FrostEvil/Industrial-Modbus-MQTT-Gateway-/node-red-dashboard/dashboard-overview.png

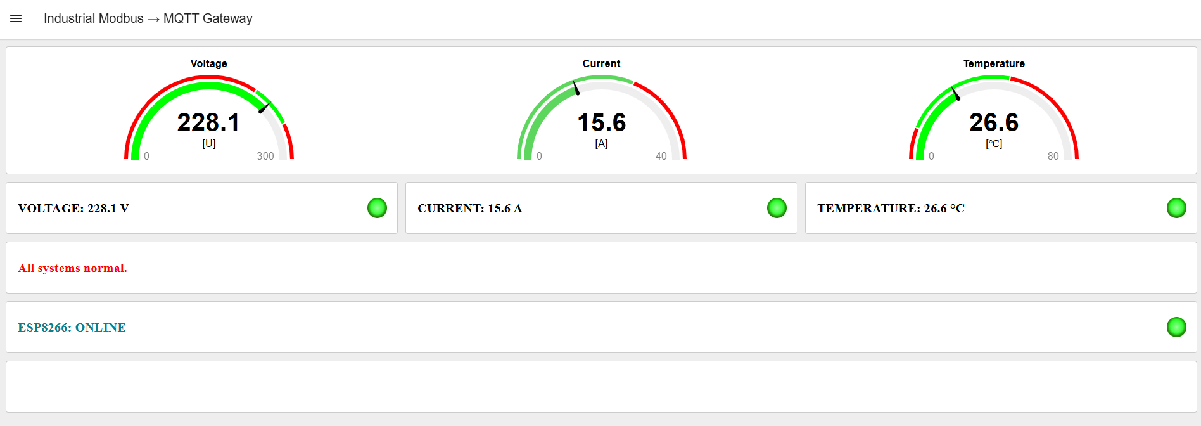
node-red-dashboard/dashboard-overview.png
