FrostEvil/Industrial-Modbus-MQTT-Gateway-/node-red-dashboard/flow-editor.png

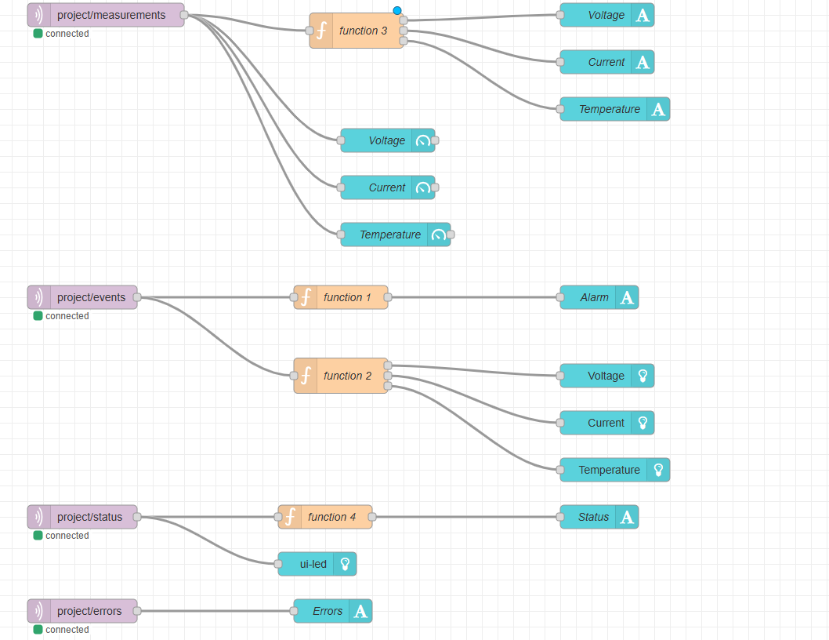
node-red-dashboard/flow-editor.png
