FrostEvil/Industrial-Modbus-MQTT-Gateway-/hardware/schematic.pdf

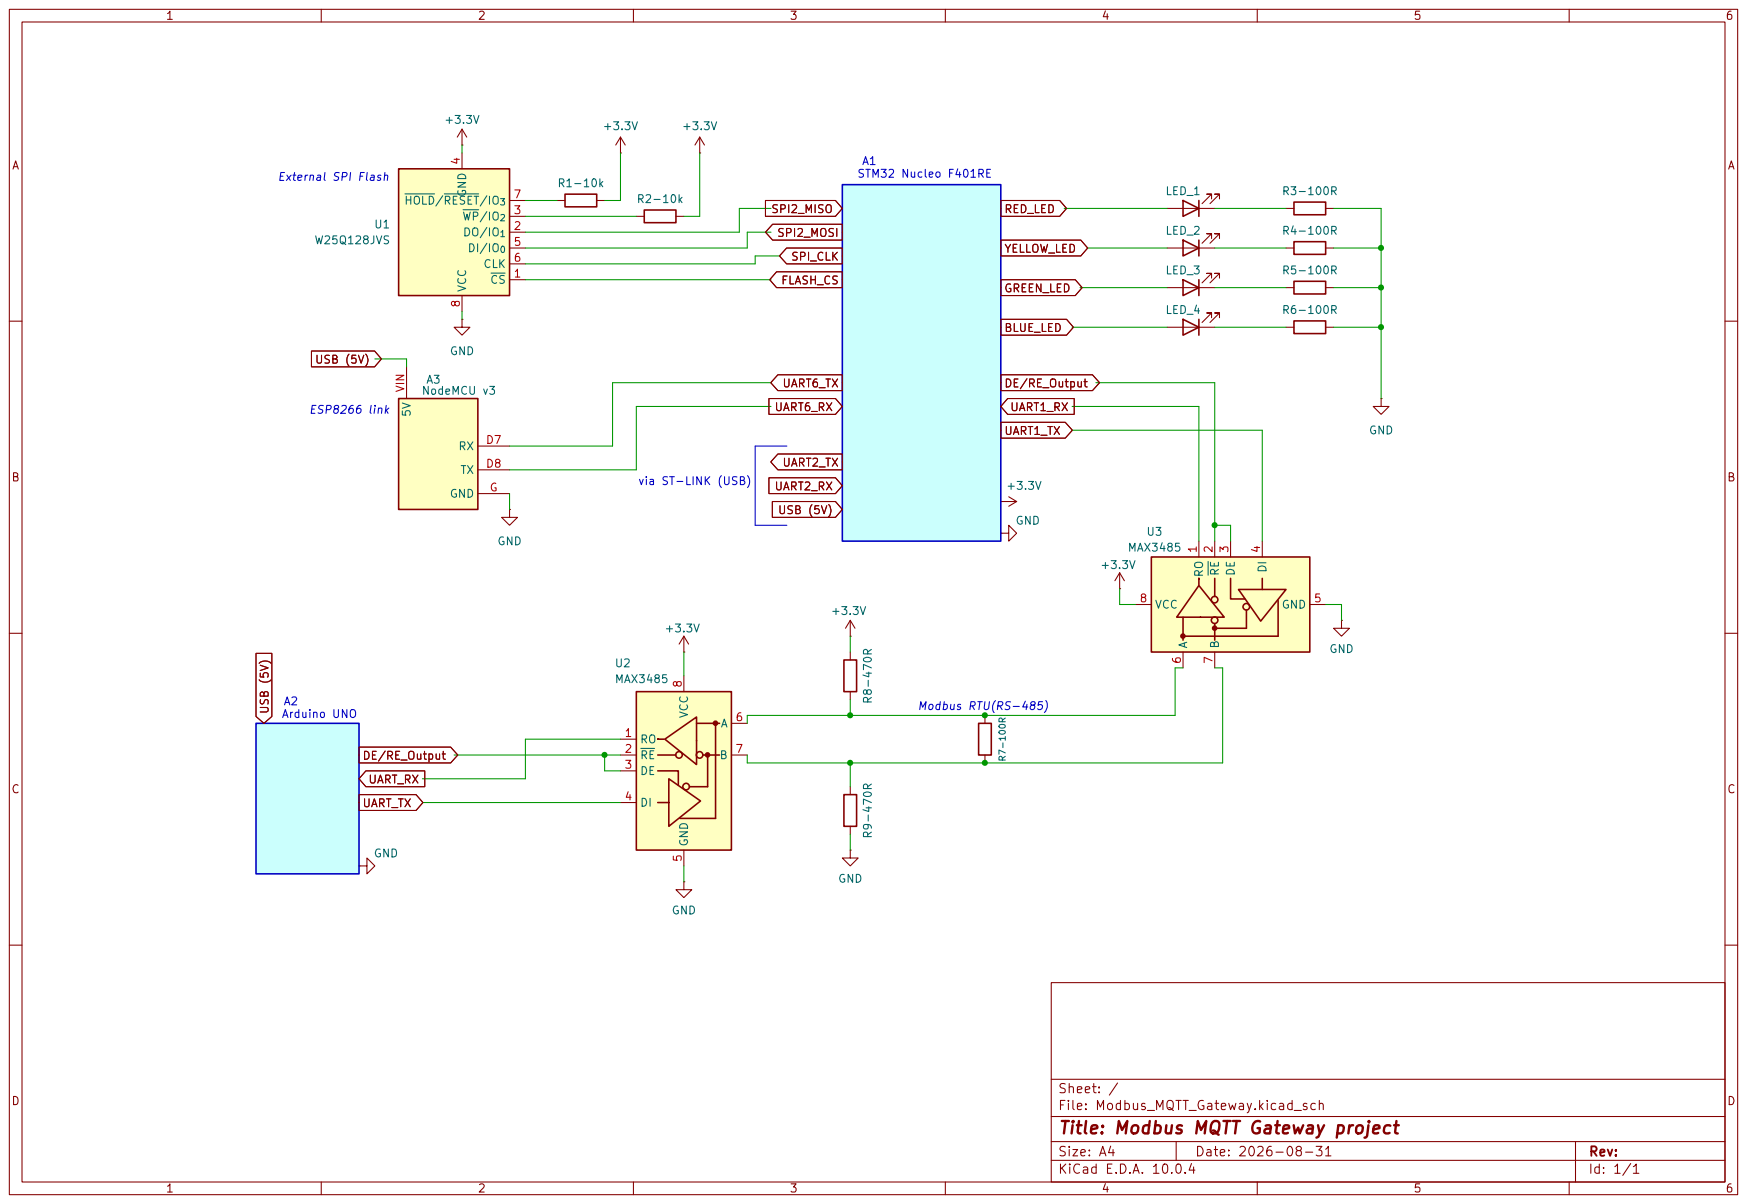
[picture p4: page 1]
