FrostEvil/Industrial-Modbus-MQTT-Gateway-/Core/Inc/main.h

#define B1_Pin GPIO_PIN_13
#define B1_GPIO_Port GPIOC
#define FLASH_CS_Pin GPIO_PIN_1
#define FLASH_CS_GPIO_Port GPIOC
#define USART_TX_Pin GPIO_PIN_2
#define USART_TX_GPIO_Port GPIOA
#define USART_RX_Pin GPIO_PIN_3
#define USART_RX_GPIO_Port GPIOA
#define LD2_Pin GPIO_PIN_5
#define LD2_GPIO_Port GPIOA
#define DE_RE_Output_Pin GPIO_PIN_12
#define DE_RE_Output_GPIO_Port GPIOB
#define ALARM_COMMUNICATION_Pin GPIO_PIN_13
#define ALARM_COMMUNICATION_GPIO_Port GPIOB
#define ALARM_MEASUREMENT_Pin GPIO_PIN_14
#define ALARM_MEASUREMENT_GPIO_Port GPIOB
#define ALARM_NORMAL_Pin GPIO_PIN_15
#define ALARM_NORMAL_GPIO_Port GPIOB
#define ALARM_STORAGE_FAULT_Pin GPIO_PIN_6
#define ALARM_STORAGE_FAULT_GPIO_Port GPIOC
#define TMS_Pin GPIO_PIN_13
#define TMS_GPIO_Port GPIOA
#define TCK_Pin GPIO_PIN_14
#define TCK_GPIO_Port GPIOA
#define SWO_Pin GPIO_PIN_3
#define SWO_GPIO_Port GPIOB
