FrostEvil/Industrial-Modbus-MQTT-Gateway-/Core/Src/alarm_manager_task.c

/*
 * alarm_manager_task.c
 *
 *  Created on: Jul 16, 2026
 *      Author: tomas
 */

#include "alarm_manager_task.h"
#include "app_queues.h"
#include "gpio.h"
#include "FreeRTOS.h"
#include "task.h"
#include "queue.h"
#include "flash_logger_task.h"
#include "flash_logger.h"
#include <string.h>
#include <stdbool.h>

#define VOLTAGE_MIN 207
#define VOLTAGE_MAX 253
#define VOLTAGE_HYSTERESIS 1

#define CURRENT_MIN 0
#define CURRENT_MAX 25
#define CURRENT_HYSTERESIS 0.5

#define TEMPERATURE_MIN 10
#define TEMPERATURE_MAX 45
#define TEMPERATURE_HYSTERESIS 1

#define MEASUREMENT_BIT_VOLTAGE   0x01
#define MEASUREMENT_BIT_CURRENT   0x02
#define MEASUREMENT_BIT_TEMP      0x04

TaskHandle_t alarmManagerTaskHandle;

#define ALARM_MANAGER_TASK_STACK_SIZE 128
static StackType_t alarmManagerTaskStack[ALARM_MANAGER_TASK_STACK_SIZE];
static StaticTask_t alarmManagerTaskTCB;

/*
 * True when value is outside [min, max]. No hysteresis here - that is
 * applied separately in update_measurement_status(), since the allowed
 * transition depends on the channel's previous state.
 */
static bool is_measurement_out_of_range(float value, float min, float max) {
	if (value <= max && value >= min) {
		return false;
	}

	return true;
}

/*
 * A channel already in alarm should not clear immediately when the value
 * crosses back over the original limit - it must first enter the narrower
 * hysteresis band.
 *
 * Example (voltage): normal range 207...253 V, hysteresis 1 V -> after an
 * alarm, the value must return to 208...252 V before it clears.
 */
static bool should_clear_alarm(float value, float min, float max,
		float hysteresis) {

	if ((value >= min + hysteresis) && (value <= max - hysteresis)) {
		return true;
	}

	return false;
}

/*
 * Update one channel using its previous state: normal limits decide
 * whether an alarm starts, hysteresis limits decide whether it clears.
 */
static MeasurementRangeStatus_t update_measurement_status(
		MeasurementRangeStatus_t current_status, float value, float min,
		float max, float hysteresis) {

	if (current_status == MEASUREMENT_IN_RANGE) {

		if (is_measurement_out_of_range(value, min, max)) {
			return MEASUREMENT_OUT_OF_RANGE;
		}

	} else {

		if (should_clear_alarm(value, min, max, hysteresis)) {
			return MEASUREMENT_IN_RANGE;
		}
	}

	return current_status;
}

/*
 * A communication error gets its own alarm state; the V/I/T channel states
 * are deliberately left untouched so a temporary Modbus failure does not
 * make the system "forget" an active measurement alarm.
 */
static void update_measurement_alarm_state(
		MeasurementRecord_t *measurement_message, AlarmState_t *alarm_state,
		MeasurementStatus_t *measurement_status) {

	if (measurement_message->status == MODBUS_OK) {

		measurement_status->voltage = update_measurement_status(
				measurement_status->voltage, measurement_message->voltage,
				VOLTAGE_MIN,
				VOLTAGE_MAX,
				VOLTAGE_HYSTERESIS);

		measurement_status->current = update_measurement_status(
				measurement_status->current, measurement_message->current,
				CURRENT_MIN,
				CURRENT_MAX,
				CURRENT_HYSTERESIS);

		measurement_status->temperature = update_measurement_status(
				measurement_status->temperature,
				measurement_message->temperature,
				TEMPERATURE_MIN,
				TEMPERATURE_MAX,
				TEMPERATURE_HYSTERESIS);

		if (measurement_status->voltage == MEASUREMENT_IN_RANGE
				&& measurement_status->current == MEASUREMENT_IN_RANGE
				&& measurement_status->temperature == MEASUREMENT_IN_RANGE) {

			*alarm_state = ALARM_NORMAL;

		} else {

			*alarm_state = ALARM_MEASUREMENT;
		}

	} else {

		*alarm_state = ALARM_COMMUNICATION;
	}
}

/*
 * Compare current vs. previous V/I/T states. trigger_channel is a bitmask
 * (|= instead of assignment) because more than one channel can change in
 * the same cycle. The previous state is updated last so the next cycle can
 * detect the following transition.
 */
static void detect_measurement_state_changes(
		const MeasurementStatus_t *measurement_status,
		MeasurementStatus_t *prev_measurement_status,
		bool *is_status_changed, uint8_t *trigger_channel) {

	if (measurement_status->voltage != prev_measurement_status->voltage) {
		*trigger_channel |= MEASUREMENT_BIT_VOLTAGE;
		*is_status_changed = true;
	}

	if (measurement_status->current != prev_measurement_status->current) {
		*trigger_channel |= MEASUREMENT_BIT_CURRENT;
		*is_status_changed = true;
	}

	if (measurement_status->temperature
			!= prev_measurement_status->temperature) {
		*trigger_channel |= MEASUREMENT_BIT_TEMP;
		*is_status_changed = true;
	}

	prev_measurement_status->voltage = measurement_status->voltage;
	prev_measurement_status->current = measurement_status->current;
	prev_measurement_status->temperature = measurement_status->temperature;
}

/*
 * Which channels are CURRENTLY out of range (as opposed to trigger_channel,
 * which is which channel changed state THIS cycle). Rebuilt from scratch
 * each time so unused bits never carry stale data.
 */
static void build_measurement_bitmask(uint8_t *measurement_bitmask,
		const MeasurementStatus_t *measurement_status) {

	*measurement_bitmask = 0x00;

	if (measurement_status->voltage == MEASUREMENT_OUT_OF_RANGE) {
		*measurement_bitmask |= MEASUREMENT_BIT_VOLTAGE;
	}

	if (measurement_status->current == MEASUREMENT_OUT_OF_RANGE) {
		*measurement_bitmask |= MEASUREMENT_BIT_CURRENT;
	}

	if (measurement_status->temperature == MEASUREMENT_OUT_OF_RANGE) {
		*measurement_bitmask |= MEASUREMENT_BIT_TEMP;
	}
}

/*
 * Measurement, communication and Flash faults are independent, so e.g. a
 * measurement alarm and a Flash fault can both be visible at once.
 */
static void update_alarm_led(AlarmState_t alarm_state,
		FlashLoggerAlarmFault_t flash_logger_alarm_fault) {

	uint8_t normal_led = (alarm_state == ALARM_NORMAL)
			&& (flash_logger_alarm_fault == ALARM_OK);

	uint8_t measurement_led = (alarm_state == ALARM_MEASUREMENT);

	uint8_t communication_led = (alarm_state == ALARM_COMMUNICATION)
			|| (flash_logger_alarm_fault == COMMUNICATION_FAULT);

	uint8_t storage_led = (flash_logger_alarm_fault == STORAGE_FAULT);

	HAL_GPIO_WritePin(
	ALARM_NORMAL_GPIO_Port,
	ALARM_NORMAL_Pin, normal_led ? GPIO_PIN_SET : GPIO_PIN_RESET);

	HAL_GPIO_WritePin(
	ALARM_MEASUREMENT_GPIO_Port,
	ALARM_MEASUREMENT_Pin, measurement_led ? GPIO_PIN_SET : GPIO_PIN_RESET);

	HAL_GPIO_WritePin(
	ALARM_COMMUNICATION_GPIO_Port,
	ALARM_COMMUNICATION_Pin, communication_led ? GPIO_PIN_SET : GPIO_PIN_RESET);

	HAL_GPIO_WritePin(
	ALARM_STORAGE_FAULT_GPIO_Port,
	ALARM_STORAGE_FAULT_Pin, storage_led ? GPIO_PIN_SET : GPIO_PIN_RESET);
}

void AlarmManagerTask(void *argument) {

	MeasurementRecord_t measurement_record;

	/*
	 * Kept separately from the current state to detect IN<->OUT transitions.
	 */
	MeasurementStatus_t prev_measurement_status = { .voltage =
			MEASUREMENT_IN_RANGE, .current = MEASUREMENT_IN_RANGE,
			.temperature = MEASUREMENT_IN_RANGE };

	MeasurementStatus_t measurement_status =
			{ .voltage = MEASUREMENT_IN_RANGE, .current = MEASUREMENT_IN_RANGE,
					.temperature = MEASUREMENT_IN_RANGE };

	bool is_measurement_status_changed = false;

	AlarmState_t measurement_alarm_state = ALARM_NORMAL;
	AlarmState_t prev_measurement_alarm_state = ALARM_NORMAL;

	FlashLoggerAlarmFault_t prev_flash_logger_alarm_fault = ALARM_OK;
	FlashLoggerAlarmFault_t flash_logger_alarm_fault = ALARM_OK;

	MqttAlarmState_t mqtt_alarm_state;

	for (;;) {

		FlashRecord_t flash_record;

		/*
		 * Opportunistic: if FlashLoggerTask hasn't posted a new status,
		 * the timeout expires and the current state is simply kept.
		 */
		xQueueReceive(flashToAlarmQueue, &flash_logger_alarm_fault,
				pdMS_TO_TICKS(100));

		/*
		 * The actual trigger for this task's cycle.
		 */
		xQueueReceive(modbusToAlarmQueue, &measurement_record,
		portMAX_DELAY);

		/*
		 * Zero the whole struct first so compiler padding has a
		 * deterministic value before it is included in the CRC below.
		 */
		memset(&flash_record, 0, sizeof(flash_record));

		flash_record.timestamp_ms = xTaskGetTickCount();
		flash_record.voltage = measurement_record.voltage;
		flash_record.current = measurement_record.current;
		flash_record.temperature = measurement_record.temperature;
		flash_record.trigger_channel = 0x00;

		update_measurement_alarm_state(&measurement_record,
				&measurement_alarm_state, &measurement_status);

		detect_measurement_state_changes(&measurement_status,
				&prev_measurement_status, &is_measurement_status_changed,
				&flash_record.trigger_channel);

		/*
		 * trigger_channel must hold its final value before this, since it
		 * is part of the CRC-protected record data.
		 */
		flash_record.crc = modbus_crc16((uint8_t*) &flash_record,
				offsetof(FlashRecord_t, crc));

		if (is_measurement_status_changed) {

			/*
			 * Non-blocking on purpose: dropping the event if the Flash
			 * queue is full is preferable to blocking alarm/LED/MQTT
			 * handling while Flash is busy. The current alarm state does
			 * not depend on the historical Flash log.
			 */
			if (xQueueSend(
					alarmToFlashQueue,
					&flash_record,
					0) != pdPASS) {
			}
		}

		/*
		 * MQTT gets an update whenever something relevant changes.
		 * xQueueOverwrite() because only the latest state matters.
		 */
		if (measurement_alarm_state != prev_measurement_alarm_state
				|| flash_logger_alarm_fault != prev_flash_logger_alarm_fault
				|| is_measurement_status_changed) {

			mqtt_alarm_state.alarm_state = measurement_alarm_state;
			mqtt_alarm_state.storage_fault = flash_logger_alarm_fault;

			build_measurement_bitmask(&mqtt_alarm_state.measurement_bitmask,
					&measurement_status);

			xQueueOverwrite(alarmToMqttQueue, &mqtt_alarm_state);
		}

		prev_measurement_alarm_state = measurement_alarm_state;
		prev_flash_logger_alarm_fault = flash_logger_alarm_fault;

		update_alarm_led(measurement_alarm_state, flash_logger_alarm_fault);

		is_measurement_status_changed = false;
	}
}

void AlarmManagerTask_Init(void) {

	alarmManagerTaskHandle = xTaskCreateStatic(AlarmManagerTask, "AlarmManager",
	ALARM_MANAGER_TASK_STACK_SIZE,
	NULL, 3, alarmManagerTaskStack, &alarmManagerTaskTCB);
}
