FrostEvil/Industrial-Modbus-MQTT-Gateway-/Core/Inc/mqtt_publisher_task.h

/*
 * mqtt_publisher_task.h
 *
 *  Created on: Jul 19, 2026
 *      Author: tomas
 */

#ifndef INC_MQTT_PUBLISHER_TASK_H_
#define INC_MQTT_PUBLISHER_TASK_H_

void MqttPublisherTask_Init(void);

#endif /* INC_MQTT_PUBLISHER_TASK_H_ */
