FrostEvil/Industrial-Modbus-MQTT-Gateway-/Hardware/hardware-setup.JPG

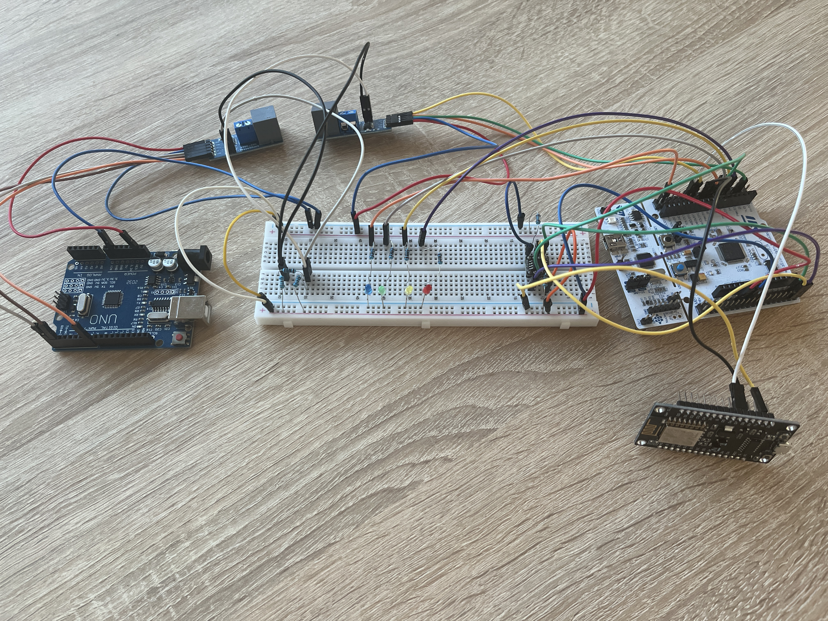
[picture p1: hardware/hardware-setup.JPG]
Hardware/hardware-setup.JPG
